linhvu97vn/19R01-Tm4c123KiCad/mainboard/images/RealBoard.jpg

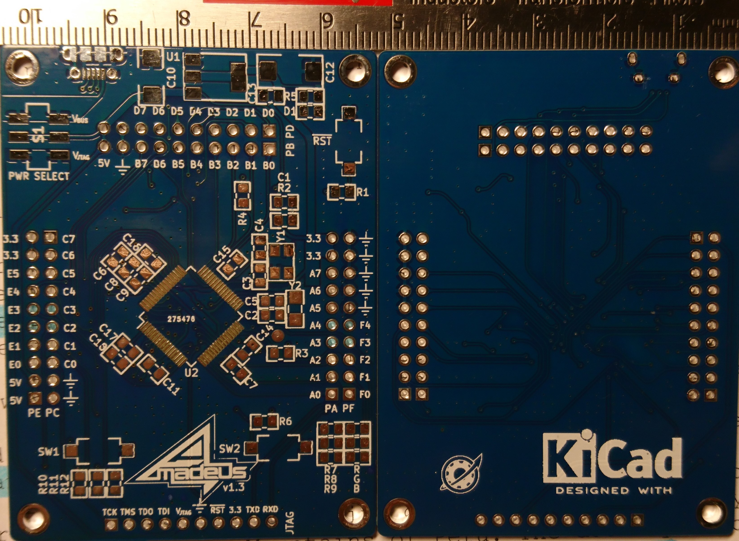
mainboard/images/RealBoard.jpg
