linhvu97vn/19R01-Tm4c123KiCad/README.md

# tm4cboard
A design board for tm4c123gh6pm using KiCad
