linhvu97vn/19R01-Tm4c123KiCad/mainboard/pdf/3Dboard.pdf

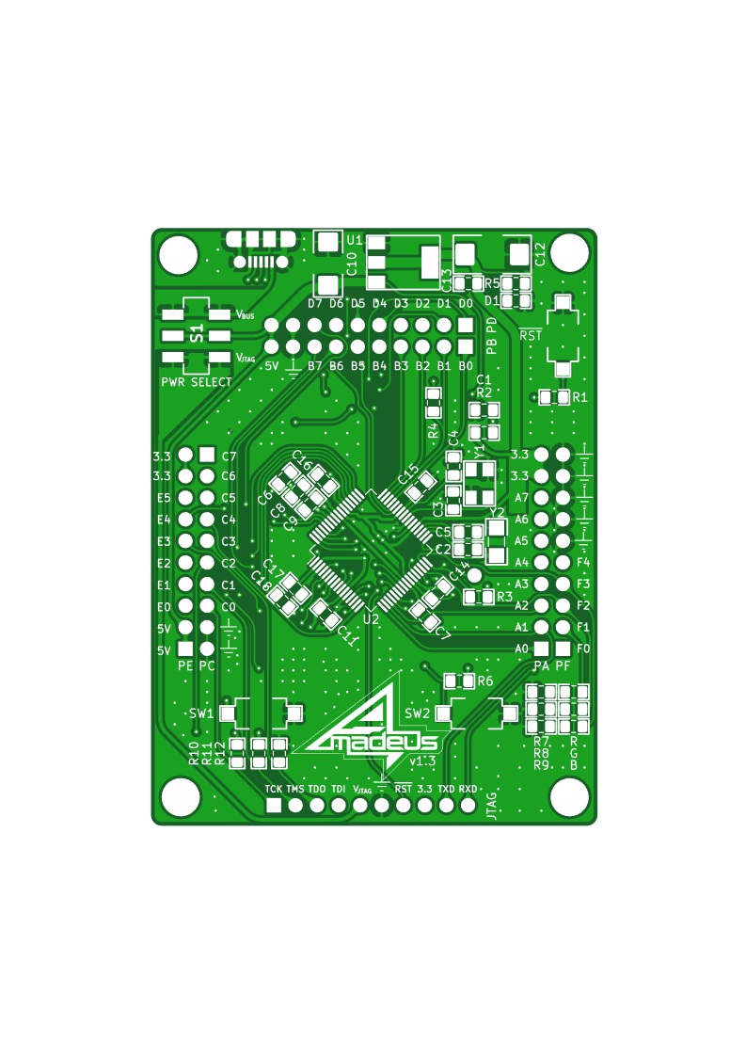
[picture p2: page 1]
