linhvu97vn/19R01-Tm4c123KiCad/mainboard/images/PowerLayout.png

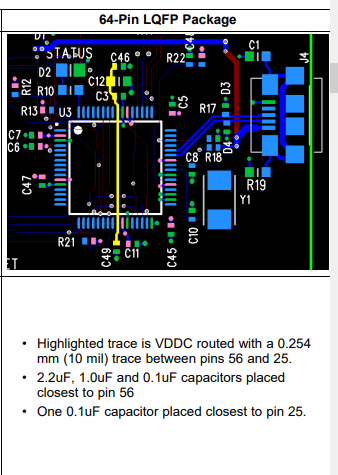
mainboard/images/PowerLayout.png
