linhvu97vn/19R01-Tm4c123KiCad/mainboard/bom/BomProcess.xlsx

 | Sourced | Placed | References | Value | Footprint | Quantity
1 | X |  | C10 | 10uF | CP_Elec_4x5.4 | 1 |  |  | pF | nF | uF
2 |  |  | C12 | 22uF | CP_Elec_4x5.4 | 1 | ????
3 | X |  | C9 | 2.2uF | C_0805_2012Metric_Pad1.15x1.40mm_HandSolder | 1
4 | X |  | R1 | 470 | R_0805_2012Metric_Pad1.15x1.40mm_HandSolder | 1
5 | X |  | R3 | 1m | R_0805_2012Metric_Pad1.15x1.40mm_HandSolder | 1
6 | X |  | R4 | 220 | R_0805_2012Metric_Pad1.15x1.40mm_HandSolder | 1
7 | X |  | U1 | LM1117-3.3 | LM1117-3.3V | 1 |  | x5 | 1. Thạnh anh 16 Mhz, SMD loại 4 chân, kích thước 3.2x2.5 mm (3225)
8 | X |  | U2 | TM4C123GH6PM | TMC123GH6PM | 1 |  | x5 | 2. Thạch anh 32.768kHz, SMD loại 2 chân, kích thước 3.2x1.5mm (3215)
9 |  |  | Y1 | Crystal_GND24_Small | Crystal_SMD_3225-4Pin_3.2x2.5mm | 1 |  | x5 | 3. Tụ phân cực, SMD, 22uF, 4x5.4
10 |  |  | Y2 | Crystal-32.768KHz | Crystal_SMD_MicroCrystal_CC7V-T1A-2Pin_3.2x1.5mm_HandSoldering | 1 |  | x10 | 4. Tụ không phân cực, SMD, 24pF, 0805
11 | X |  | JTAG | JTAG Port | PinHeader_1x10_P2.54mm_Vertical | 1 |  | x1 | 5. Biến trở loại 1k Ohm
12 | X |  | PA | A Port | PinHeader_1x10_P2.54mm_Vertical | 1
13 | X |  | PB | B Port | PinHeader_1x10_P2.54mm_Vertical | 1
14 | X |  | PD | D Port | PinHeader_1x10_P2.54mm_Vertical | 1
15 | X |  | PE | E Port | PinHeader_1x10_P2.54mm_Vertical | 1
16 | X |  | PF | F Port | PinHeader_1x10_P2.54mm_Vertical | 1
17 | X |  | S1 | JS202011SCQN | Slide_Switch_2.54mm | 1
18 | X |  | J2 | HIB | PinHeader_1x01_P2.54mm_Vertical | 1
19 | X |  | J4 | PC | PinHeader_1x10_P2.54mm_Vertical | 1
20 | X |  | J1 | USB_OTG | USB_Micro-B_Molex | 1
21 |  |  | C2, C5 | 24pF | C_0805_2012Metric_Pad1.15x1.40mm_HandSolder | 2 | ????
22 | X |  | C3, C4 | 10pF | C_0805_2012Metric_Pad1.15x1.40mm_HandSolder | 2
23 | X |  | C8, C17 | 1uF | C_0805_2012Metric_Pad1.15x1.40mm_HandSolder | 2
24 | X |  | C15, C18 | 0.01uF | C_0805_2012Metric_Pad1.15x1.40mm_HandSolder | 2
25 | X |  | SW1, SW2, ~RST | SW_Push | Buttons | 3
26 | X |  | R2, R10, R11, R12 | 10k | R_0805_2012Metric_Pad1.15x1.40mm_HandSolder | 4
27 | X |  | B, D1, G, R | LED | LED_0805_2012Metric_Pad1.15x1.40mm_HandSolder | 4
28 | X |  | R5, R6, R7, R8, R9 | 330 | R_0805_2012Metric_Pad1.15x1.40mm_HandSolder | 5
29 | X |  | C1, C6, C7, C11, C13, C14, C16 | 0.1uF | C_0805_2012Metric_Pad1.15x1.40mm_HandSolder | 7
