linhvu97vn/19R01-Tm4c123KiCad/mainboard/pdf/Schematic_color.pdf

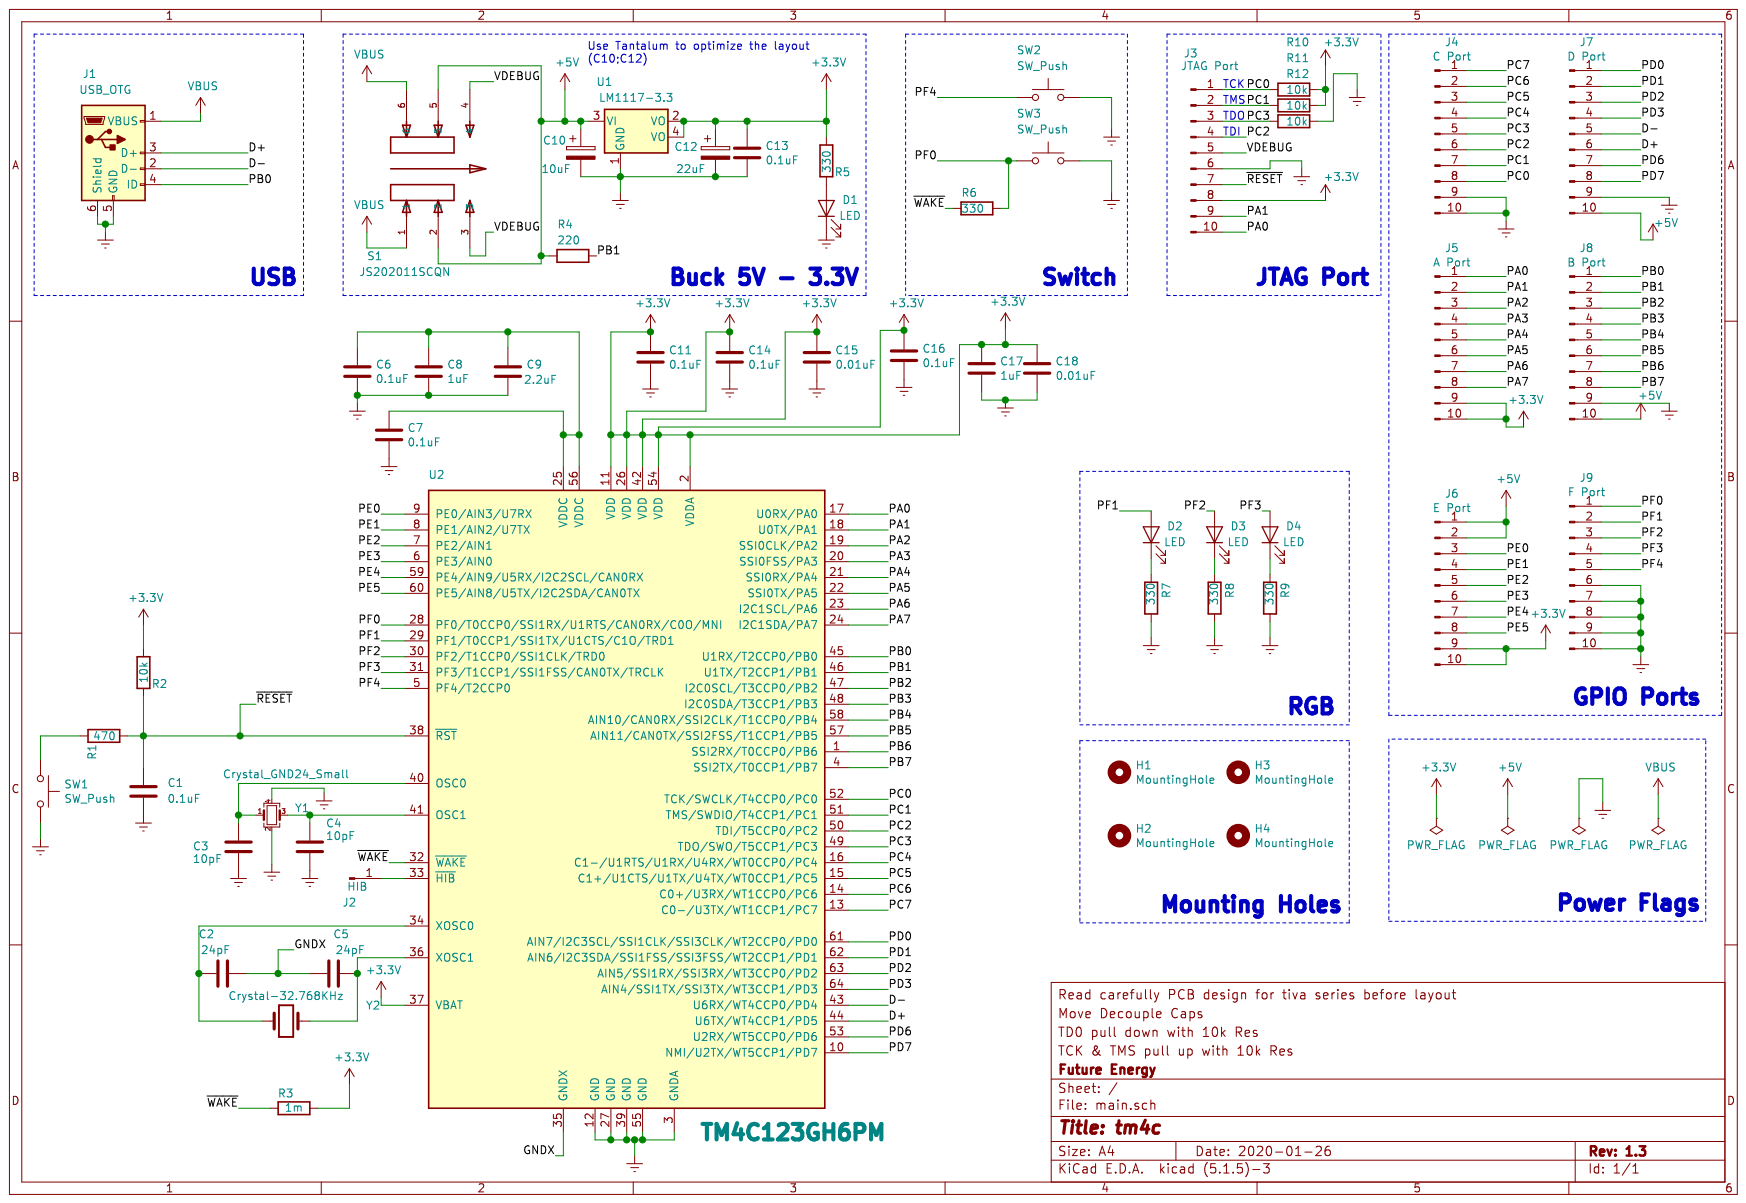
[picture p4: page 1]
