linhvu97vn/19R01-Tm4c123KiCad/mainboard/pdf/Schematic.pdf

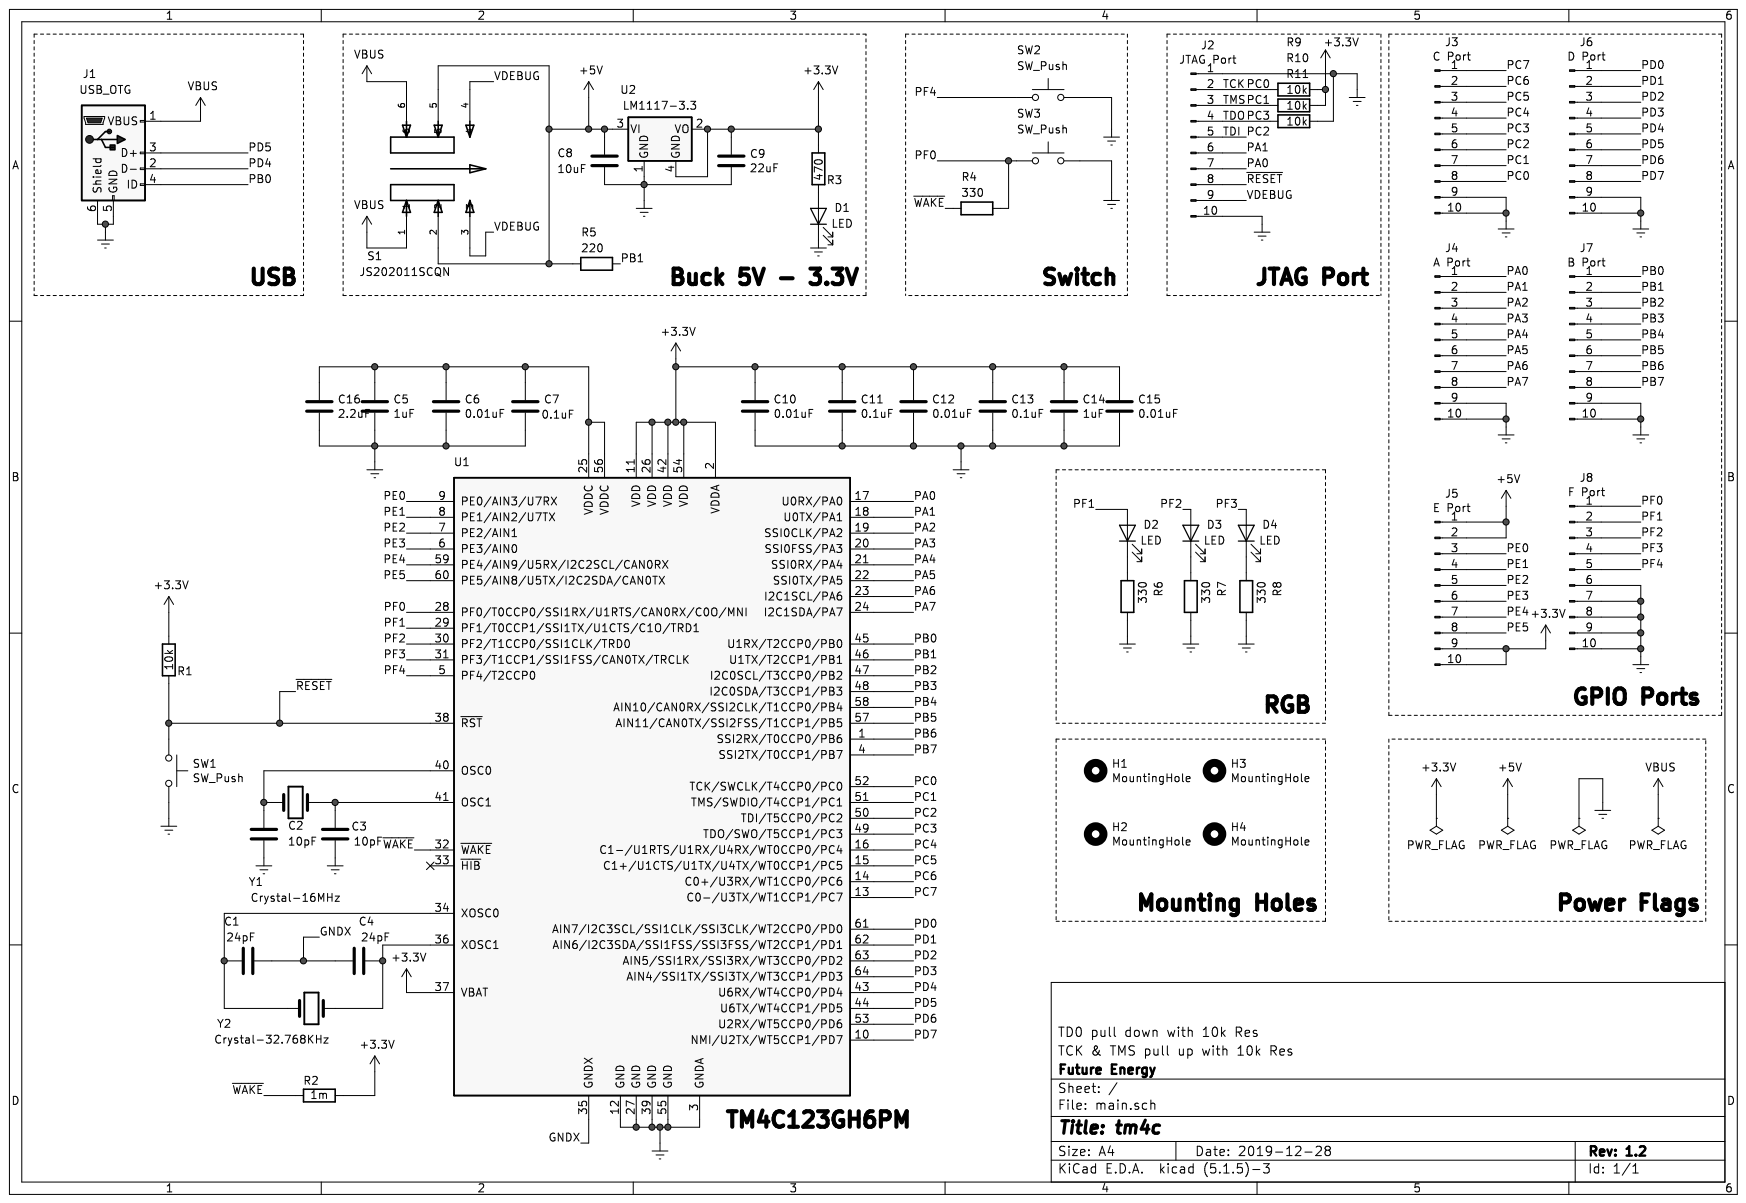
[picture p5: page 1]
