linhvu97vn/19R01-Tm4c123KiCad/mainboard/pdf/PCB.pdf

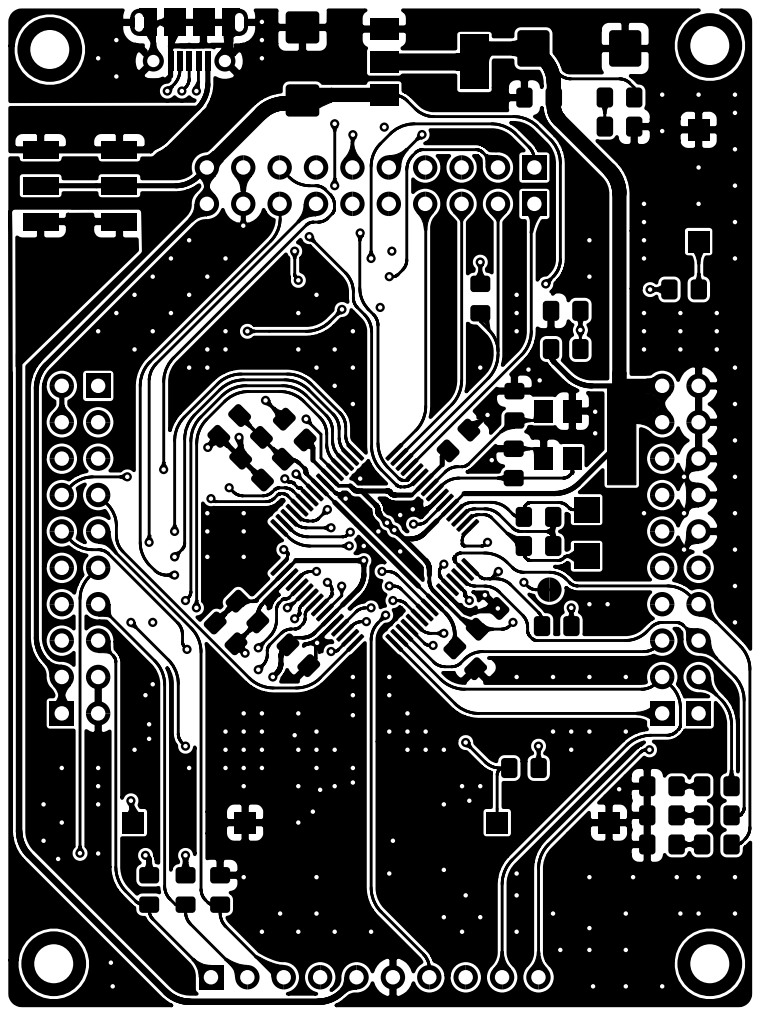
[picture p6: page 1]

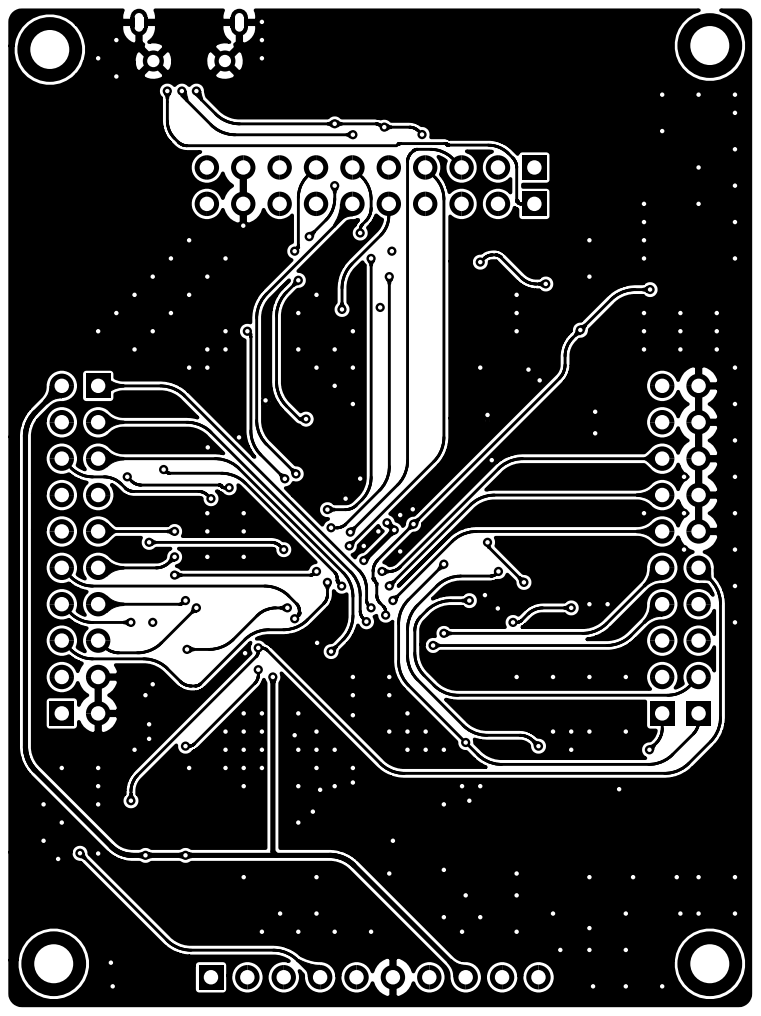
[picture p7: page 2]

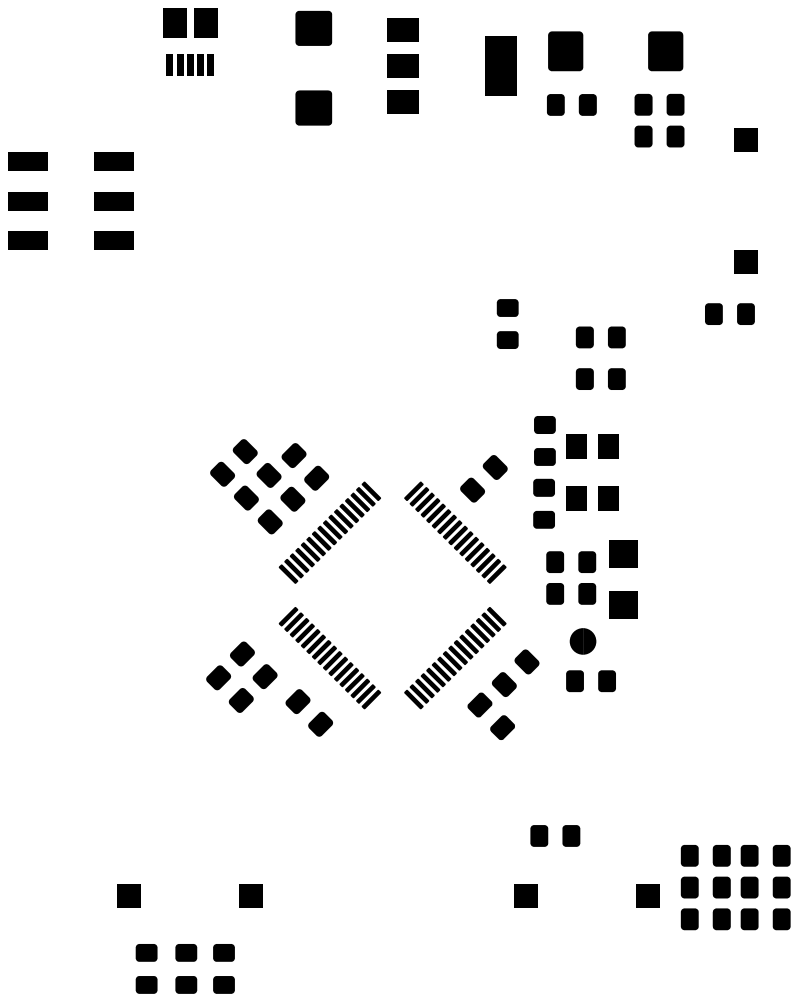
[picture p8: page 3]

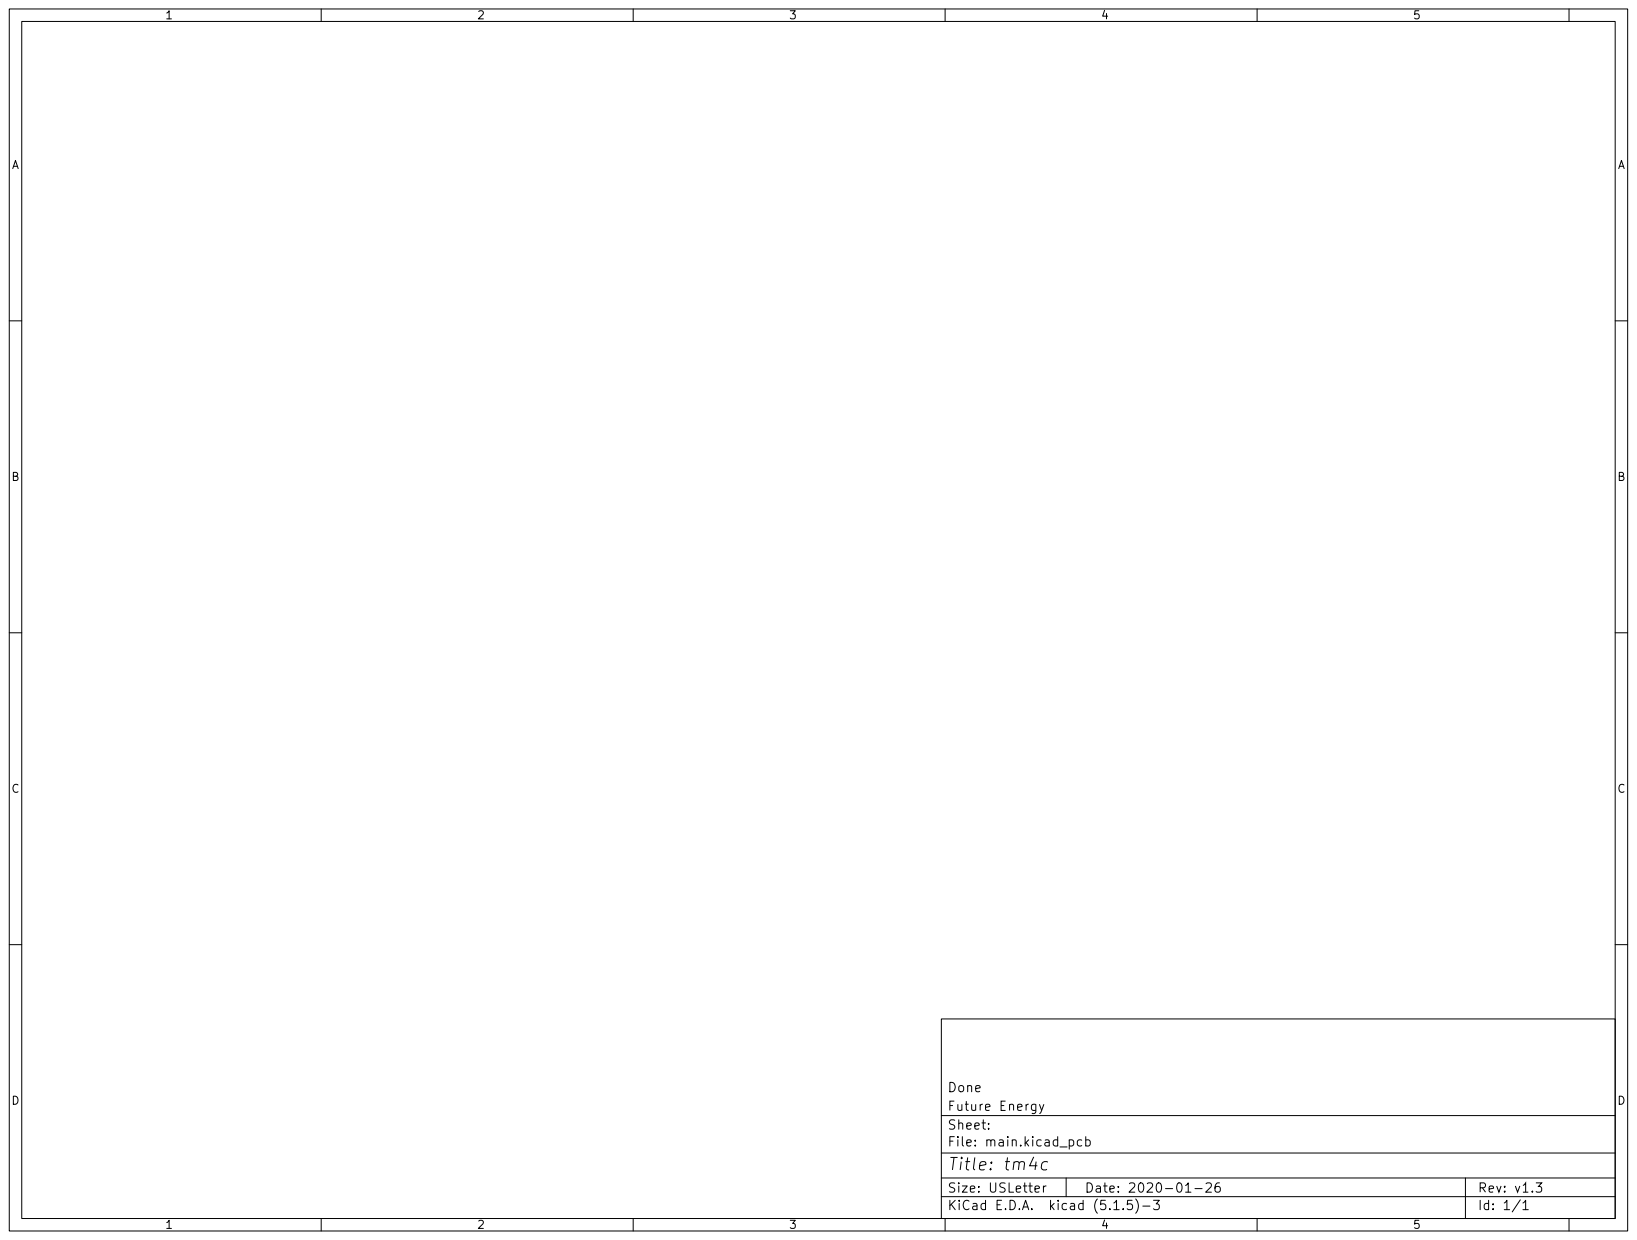
[picture p9: page 4]

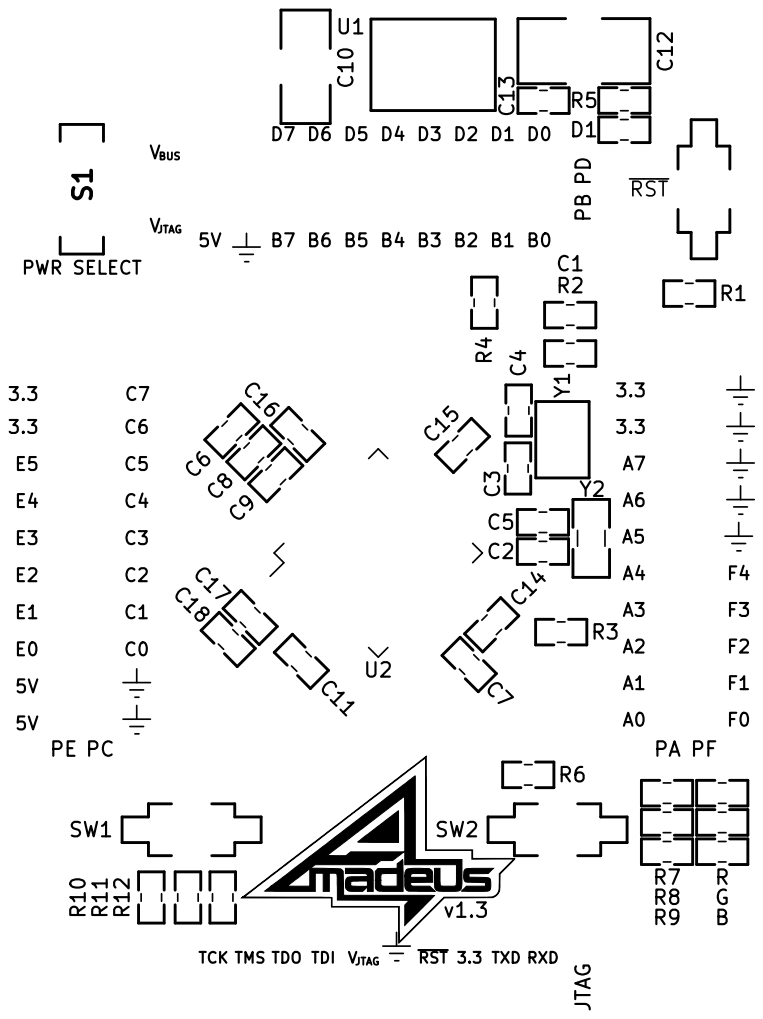
[picture p10: page 5]

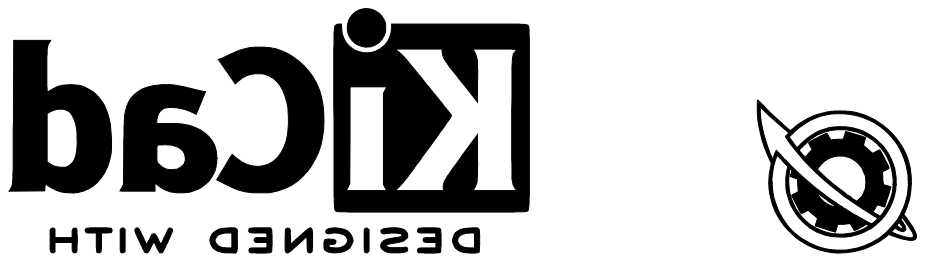
[picture p11: page 6]

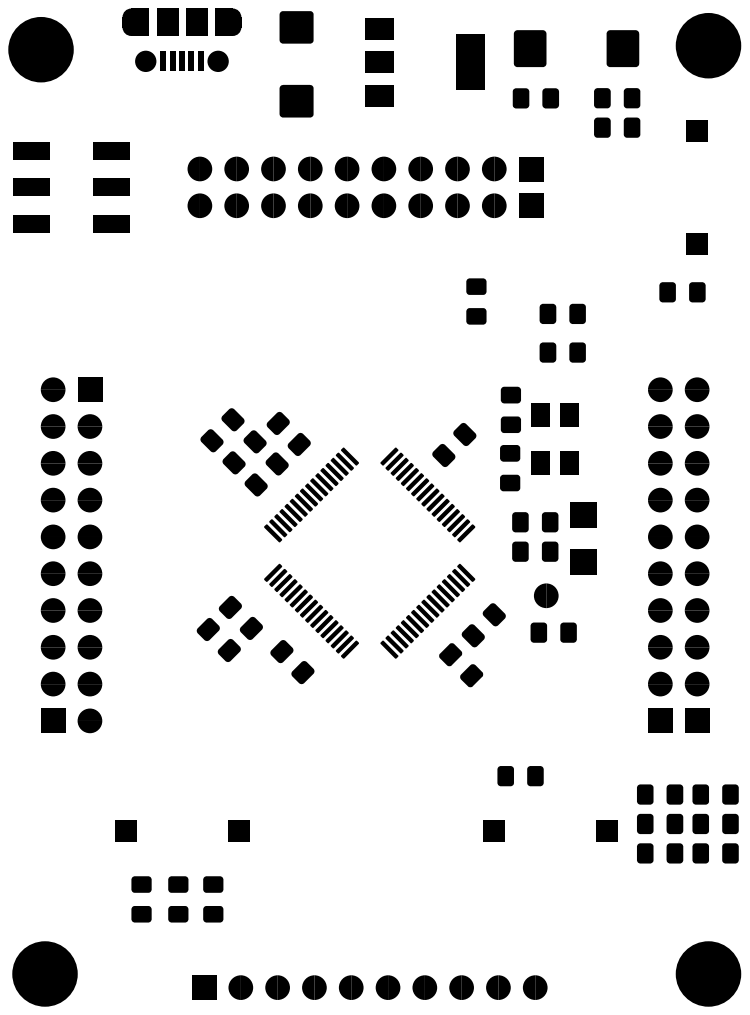
[picture p12: page 7]

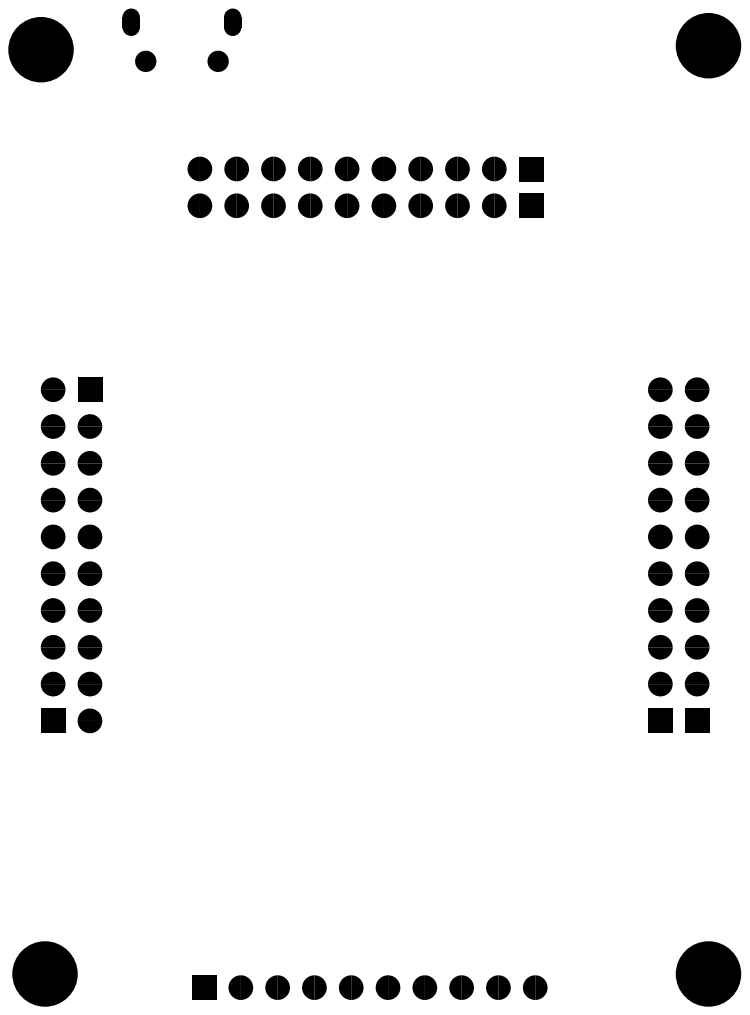
[picture p13: page 8]

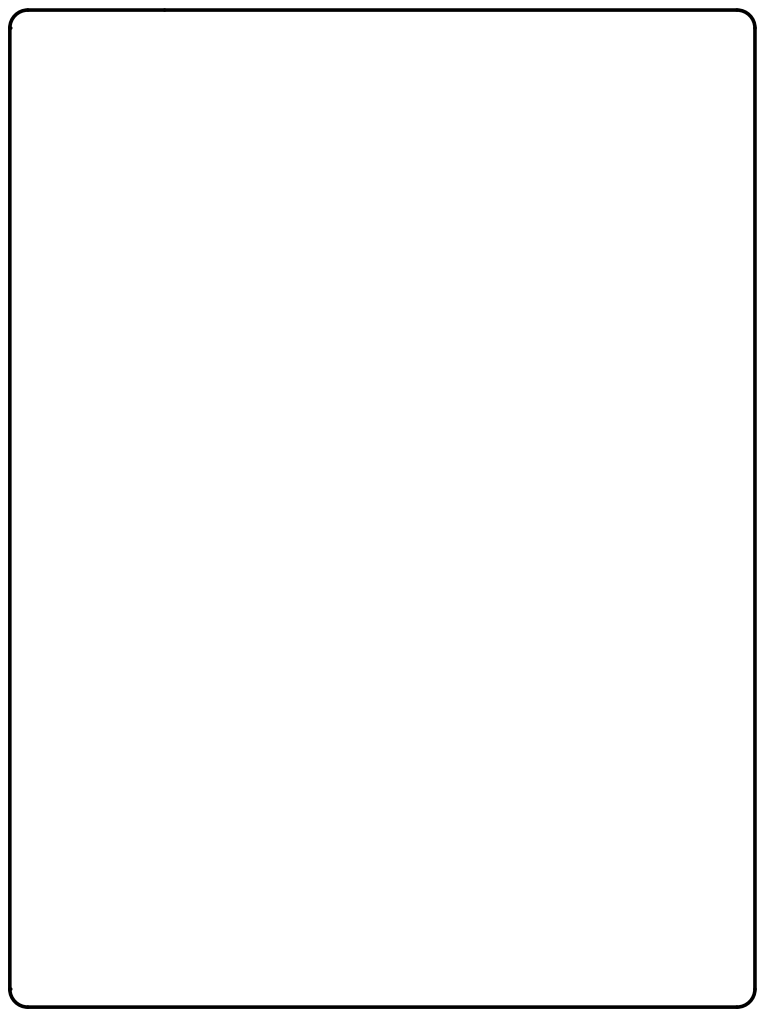
[picture p14: page 9]
