linhvu97vn/19R01-Tm4c123KiCad/mainboard/main.kicad_pcb

## KiCad design mainboard/main.kicad_pcb (2020-02-12)

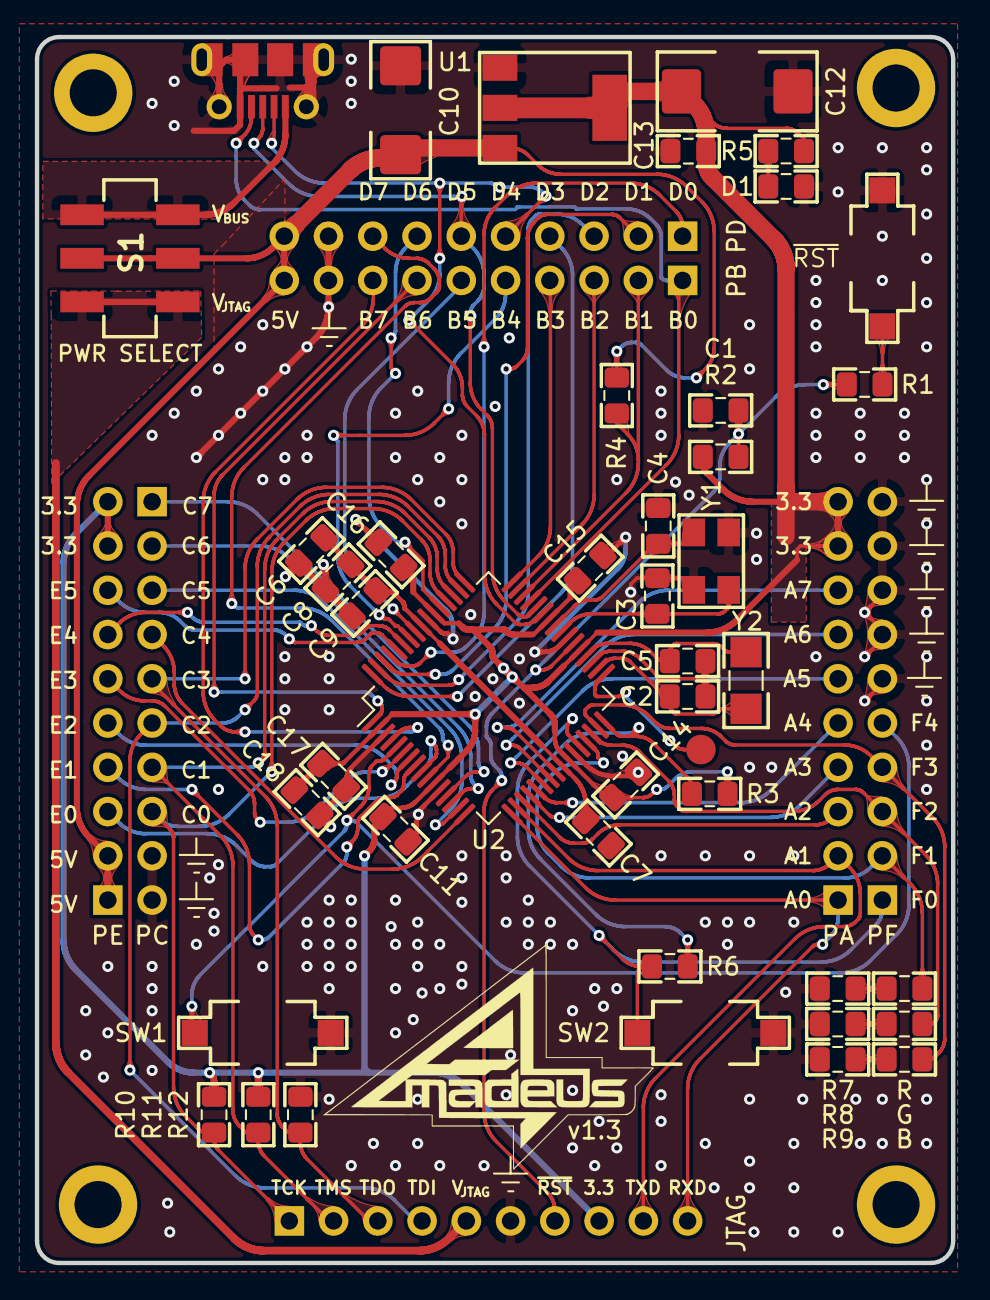
[picture p23: board main.kicad_pcb from above]

Board: 2 copper layers, 52.6 x 70.4 mm, 54 parts (0 on the bottom side), 61 nets.

Parts:
B: LED; LED_0805_2012Metric_Pad1.15x1.40mm_HandSolder
C1, C6, C7, C11, C13, C14, C16: 0.1uF; C_0805_2012Metric_Pad1.15x1.40mm_HandSolder
C2, C5: 24pF; C_0805_2012Metric_Pad1.15x1.40mm_HandSolder
C3, C4: 10pF; C_0805_2012Metric_Pad1.15x1.40mm_HandSolder
C8, C17: 1uF; C_0805_2012Metric_Pad1.15x1.40mm_HandSolder
C9: 2.2uF; C_0805_2012Metric_Pad1.15x1.40mm_HandSolder
C10: 10uF; tantalum6032
C12: 22uF; tantalum7343
C15, C18: 0.01uF; C_0805_2012Metric_Pad1.15x1.40mm_HandSolder
D1: LED; LED_0805_2012Metric_Pad1.15x1.40mm_HandSolder
G: LED; LED_0805_2012Metric_Pad1.15x1.40mm_HandSolder
H1, H2, H3, H4: MountingHole; MountingHole_2.7mm_M2.5_ISO14580_Pad
J1: USB_OTG; USB_Micro-B_Molex
J2: HIB; PinHeader_1x01_P2.54mm_Vertical
JTAG: JTAG Port; PinHeader_1x10_P2.54mm_Vertical
PA: A Port; PinHeader_1x10_P2.54mm_Vertical
PB: B Port; PinHeader_1x10_P2.54mm_Vertical
PD: D Port; PinHeader_1x10_P2.54mm_Vertical
PE: E Port; PinHeader_1x10_P2.54mm_Vertical
PF: F Port; PinHeader_1x10_P2.54mm_Vertical
PWR SELECT: PC; PinHeader_1x10_P2.54mm_Vertical
R: LED; LED_0805_2012Metric_Pad1.15x1.40mm_HandSolder
R1: 470; R_0805_2012Metric_Pad1.15x1.40mm_HandSolder
R2, R10, R11, R12: 10k; R_0805_2012Metric_Pad1.15x1.40mm_HandSolder
R3: 1m; R_0805_2012Metric_Pad1.15x1.40mm_HandSolder
R4: 220; R_0805_2012Metric_Pad1.15x1.40mm_HandSolder
R5, R6, R7, R8, R9: 330; R_0805_2012Metric_Pad1.15x1.40mm_HandSolder
S1: JS202011SCQN; Slide_Switch_2.54mm
SW1, SW2: SW_Push; Buttons
U1: LM1117-3.3; LM1117-3.3V
U2: TM4C123GH6PM; TMC123GH6PM
Y1: Crystal_GND24_Small; Crystal_SMD_5032-4Pin_5.0x3.2mm
Y2: Crystal-32.768KHz; Crystal_SMD_MicroCrystal_CC7V-T1A-2Pin_3.2x1.5mm_HandSolder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

Connections:
+3V3: C11.1, C12.1, C13.1, C14.1, C15.1, C16.1, C17.1, C18.1, JTAG.8, PA.9, PA.10, PE.9, PE.10, R2.1, R3.2, R5.1, R10.1, R11.1, U1.2, U1.4, U2.2, U2.11, U2.26, U2.37, U2.42, U2.54
+5V: C10.1, PB.10, PD.10, PE.1, PE.2, R4.2, S1.2, S1.5, U1.3
/D+: J1.3, PD.6, U2.44
/D-: J1.2, PD.5, U2.43
/GNDX: C2.2, C5.1, U2.35
/PA0: JTAG.10, PA.1, U2.17
/PA1: JTAG.9, PA.2, U2.18
/PA2: PA.3, U2.19
/PA3: PA.4, U2.20
/PA4: PA.5, U2.21
/PA5: PA.6, U2.22
/PA6: PA.7, U2.23
/PA7: PA.8, U2.24
/PB0: J1.4, PB.1, U2.45
/PB1: PB.2, R4.1, U2.46
/PB2: PB.3, U2.47
/PB3: PB.4, U2.48
/PB4: PB.5, U2.58
/PB5: PB.6, U2.57
/PB6: PB.7, U2.1
/PB7: PB.8, U2.4
/PC0: JTAG.1, PWR SELECT.8, R10.2, U2.52
/PC1: JTAG.2, PWR SELECT.7, R11.2, U2.51
/PC2: JTAG.4, PWR SELECT.6, U2.50
/PC3: JTAG.3, PWR SELECT.5, R12.2, U2.49
/PC4: PWR SELECT.4, U2.16
/PC5: PWR SELECT.3, U2.15
/PC6: PWR SELECT.2, U2.14
/PC7: PWR SELECT.1, U2.13
/PD0: PD.1, U2.61
/PD1: PD.2, U2.62
/PD2: PD.3, U2.63
/PD3: PD.4, U2.64
/PD6: PD.7, U2.53
/PD7: PD.8, U2.10
/PE0: PE.3, U2.9
/PE1: PE.4, U2.8
/PE2: PE.5, U2.7
/PE3: PE.6, U2.6
/PE4: PE.7, U2.59
/PE5: PE.8, U2.60
/PF0: PF.1, R6.1, SW2.1, U2.28
/PF1: PF.2, R.2, U2.29
/PF2: G.2, PF.3, U2.30
/PF3: B.2, PF.4, U2.31
/PF4: PF.5, SW1.1, U2.5
/VDEBUG: JTAG.5, S1.3, S1.4
/~RESET: C1.2, JTAG.7, R1.1, R2.2, U2.38
/~WAKE: R3.1, R6.2, U2.32
Earth: C1.1, C3.1, C4.2, C6.2, C7.2, C8.2, C9.2, C10.2, C11.2, C12.2, C13.2, C14.2, C15.2, C16.2, C17.2, C18.2, D1.1, J1.5, J1.6, JTAG.6, PB.9, PD.9, PF.6, PF.7, PF.8, PF.9, PF.10, PWR SELECT.9, PWR SELECT.10, R7.1, R8.1, R9.1, R12.1, SW1.2, SW2.2, U1.1, U2.3, U2.12, U2.27, U2.39, U2.55, Y1.2, Y1.4
unnamed: C2.1, U2.34, Y2.1
unnamed: C3.2, U2.40, Y1.1
unnamed: C4.1, U2.41, Y1.3
unnamed: C5.2, U2.36, Y2.2
unnamed: C6.1, C7.1, C8.1, C9.1, U2.25, U2.56
unnamed: D1.2, R5.2
unnamed: R.1, R7.2
unnamed: G.1, R8.2
unnamed: B.1, R9.2
unnamed: J2.1, U2.33
VBUS: J1.1, S1.1, S1.6
