linhvu97vn/19R01-Tm4c123KiCad/(commit log)

2020-01-02 main files
    [main.kicad_pcb, main.sch]
2020-01-03 Updated
    Cập nhật lại điện trở treo cho JTAG
    Thay thạch anh SMD thành loại dễ tìm hơn
    [main.kicad_pcb, main.sch]
2020-01-04 Updated a little
    [main-B_Cu.gbr, main-B_Mask.gbr, main-B_Paste.gbr, main-B_SilkS.gbr, main-Edge_Cuts.gbr, main-F_Cu.gbr, main-F_Mask.gbr, main-F_Paste.gbr]
2020-01-09 Update to v1.3
    [LastBP.kicad_pcb, main.kicad_pcb, main.sch]
2020-01-29 Updated v1.3
    [BomProcess.xlsx, LastBP.kicad_pcb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]
